jumper385/rover-vcu/CHANGELOG.md

## 0.3.2 (2026-09-02)

### Fix

- replace PN for switcher due to chip blowup

## 0.3.1 (2026-08-02)

### Fix

- removed 3v3 on 1.2v lan core voltage

## 0.3.0 (2026-07-20)

### Feat

- implmeneted revamp with normal ethernet LAN8742A

### Fix

- **eth_phy**: completed revamp with lan8742a

## 0.2.4 (2026-06-16)

### Fix

- added leds to phy

## 0.2.3 (2026-06-15)

### Fix

- tiny fixes; adjusted pin names as check

## 0.2.2 (2026-06-14)

### Fix

- updated 12pin connector footprint + fix drc and exposed vias
- added annotations and 3d models
- final polishes for MFR

## 0.2.1 (2026-06-11)

### Fix

- adde more changes from excel checklist for eth phy
- cleaned up DRC and ERC's for major errors

## 0.2.0 (2026-06-08)

### Feat

- added MVP routing implementation

### Fix

- centering board on layout
- adjusted PNs for PSU systems

## 0.1.0 (2026-06-08)

### Feat

- added can bus channels and psu
- added eth and can with
- completed h63 implementation
- added stm32h563
- added mcu
