jumper385/rover-vcu/Rover VCU.kicad_pcb

## KiCad design Rover VCU.kicad_pcb (2026-08-02)

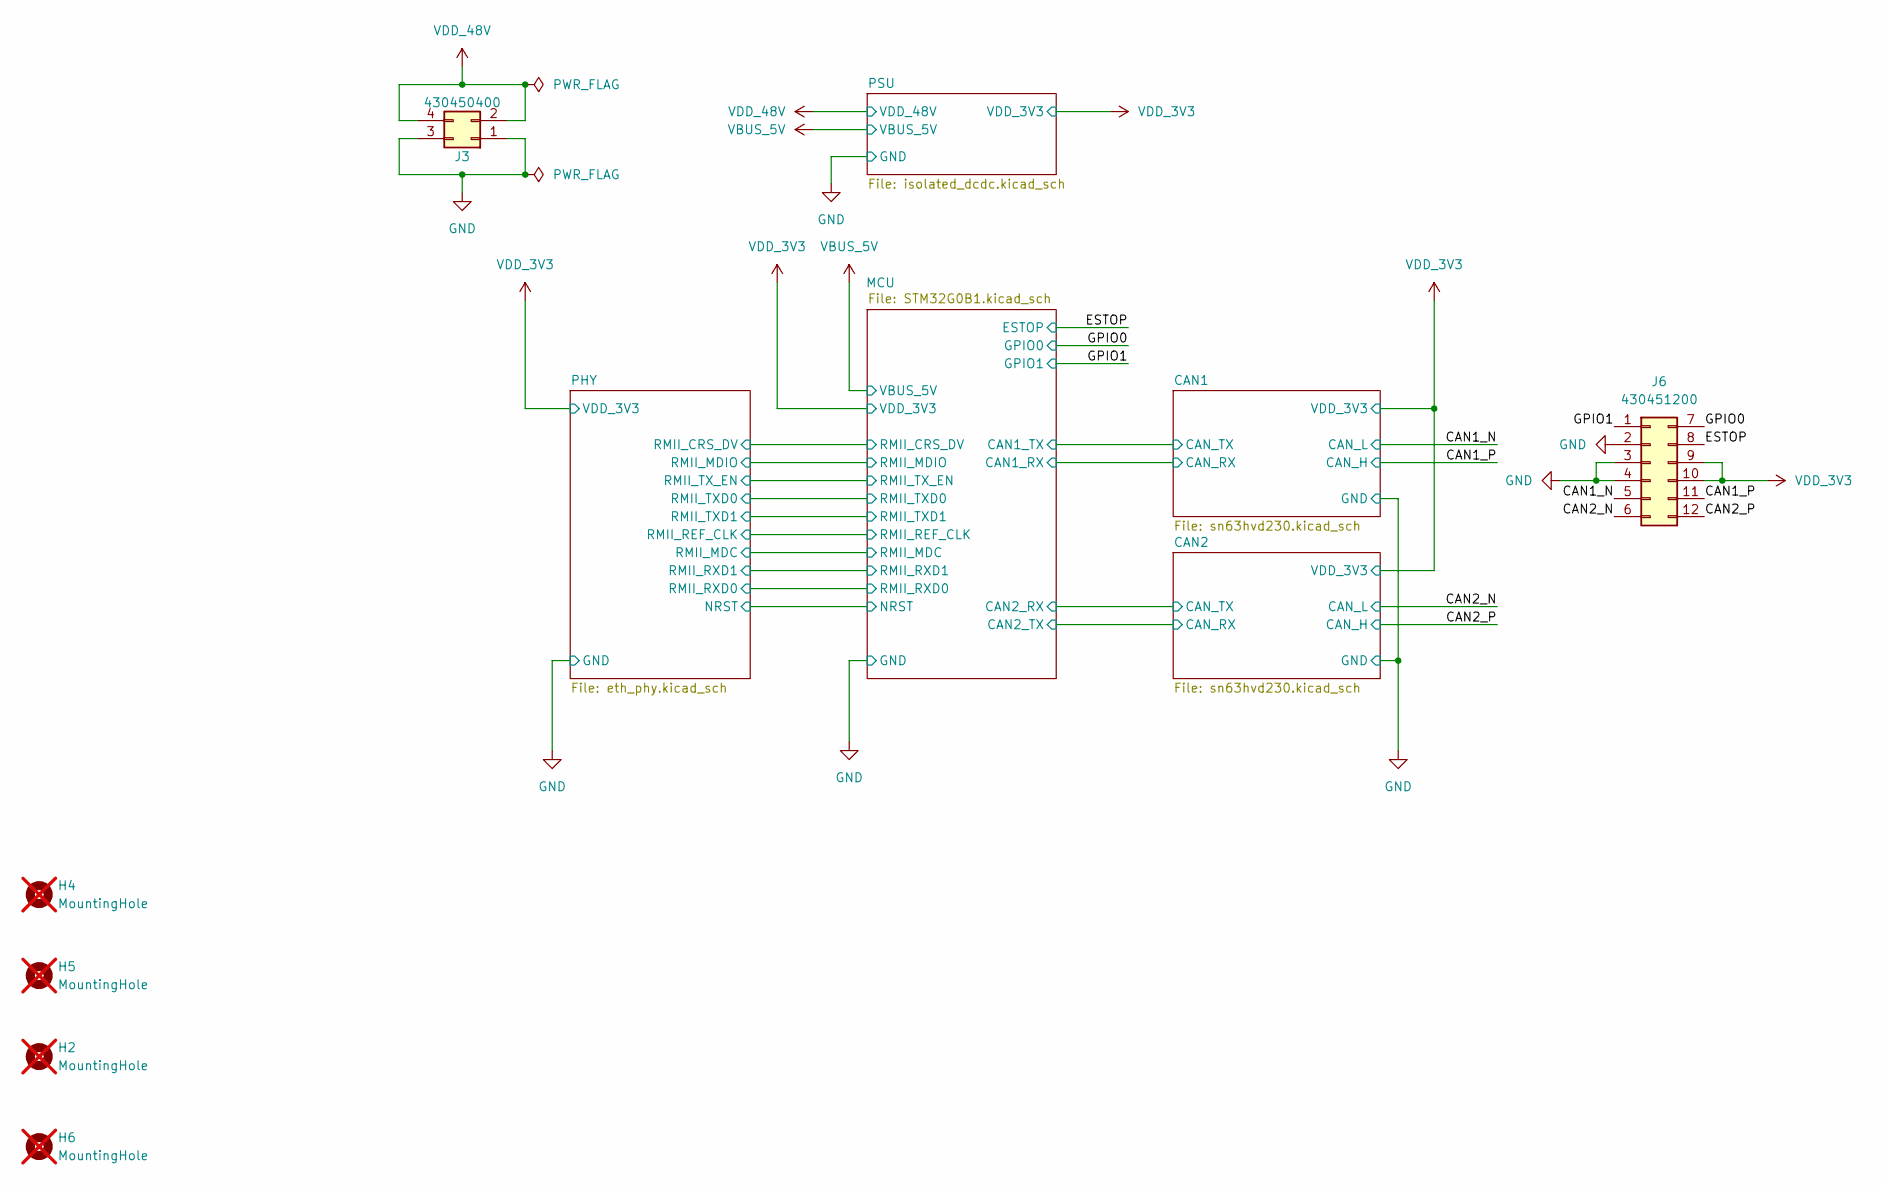
[picture p1: schematic Rover VCU.kicad_sch]

Parts:
H2, H4, H5, H6: MountingHole; MountingHole_3.2mm_M3; not fitted
J3: 430450400; Molex_Micro-Fit_3.0_43045-0400_2x02_P3.00mm_Horizontal; MFR_PN1 430450400; JLC_PN C122413
J6: 430451200; Molex_Micro-Fit_3.0_43045-1200_2x06_P3.00mm_Horizontal; MFR_PN1 430451200; JLC_PN C277636

Connections:
/CAN1_N: J6.5; also elsewhere on the board
/CAN1_P: J6.11; also elsewhere on the board
/CAN2_N: J6.6; also elsewhere on the board
/CAN2_P: J6.12; also elsewhere on the board
/ESTOP: J6.8; also elsewhere on the board
/GPIO0: J6.7; also elsewhere on the board
/GPIO1: J6.1; also elsewhere on the board
/VDD_3V3: J6.9, J6.10; also elsewhere on the board
/VDD_48V: J3.2, J3.4; also elsewhere on the board
GND: J3.1, J3.3, J6.2, J6.3, J6.4; also elsewhere on the board

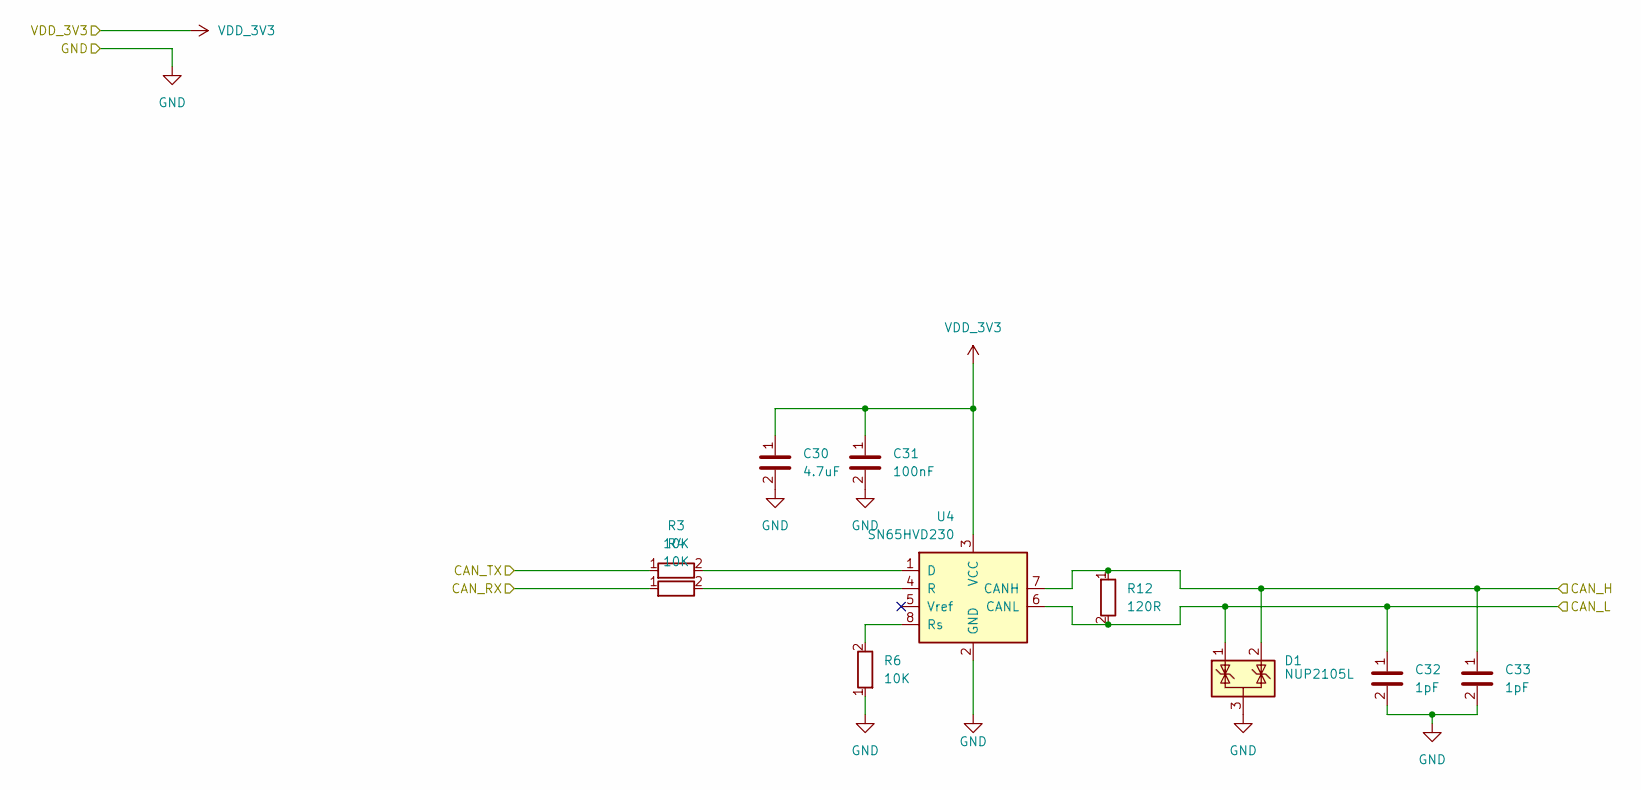
[picture p2: schematic sn63hvd230.kicad_sch]

Parts:
C30: 4.7uF; C_0402; Voltage Rating 10V; MFR_PN1 CL05A475MP5NRNC; JLC_PN C23733
C31: 100nF; C_0402; Voltage Rating 16V; MFR_PN1 CL05B104KO5NNNC; JLC_PN C1525
C32, C33: 1pF; C_0402; Voltage Rating 50V; MFR_PN1 0402CG1R0C500NT; JLC_PN C1550
D1: NUP2105L; SOT-23; MFR_PN1 NUP2105LT1G; JLC_PN C20617923
R3, R4, R6: 10K; R_0402; JLC_PN C25744
R12: 120R; R_0402; MFR_PN1 0402WGF1200TCE; JLC_PN C25079
U4: SN65HVD230; SOIC-8_3.9x4.9mm_P1.27mm; MFR_PN1 SN65HVD230DR; JLC_PN C12084

Connections:
/CAN1_N: C32.1, D1.1 (K), R12.2, U4.6 (CANL); also elsewhere on the board
/CAN1_P: C33.1, D1.2 (K), R12.1, U4.7 (CANH); also elsewhere on the board
/MCU/CAN1_RX: R4.1; also elsewhere on the board
/MCU/CAN1_TX: R3.1; also elsewhere on the board
/VDD_3V3: C30.1, C31.1, U4.3 (VCC); also elsewhere on the board
GND: C30.2, C31.2, C32.2, C33.2, D1.3 (A), R6.1, U4.2 (GND); also elsewhere on the board
unnamed: R3.2, U4.1 (D)
unnamed: R4.2, U4.4 (R)
unnamed: R6.2, U4.8 (Rs)

Parts of its further copies:
C34: 4.7uF; C_0402; Voltage Rating 10V; MFR_PN1 CL05A475MP5NRNC; JLC_PN C23733
C35: 100nF; C_0402; Voltage Rating 16V; MFR_PN1 CL05B104KO5NNNC; JLC_PN C1525
C36, C37: 1pF; C_0402; Voltage Rating 50V; MFR_PN1 0402CG1R0C500NT; JLC_PN C1550
D2: NUP2105L; SOT-23; MFR_PN1 NUP2105LT1G; JLC_PN C20617923
R7, R8, R9: 10K; R_0402; JLC_PN C25744
R13: 120R; R_0402; MFR_PN1 0402WGF1200TCE; JLC_PN C25079
U5: SN65HVD230; SOIC-8_3.9x4.9mm_P1.27mm; MFR_PN1 SN65HVD230DR; JLC_PN C12084

Connections of its further copies:
/CAN2_N: C36.1, D2.1 (K), R13.2, U5.6 (CANL); also elsewhere on the board
/CAN2_P: C37.1, D2.2 (K), R13.1, U5.7 (CANH); also elsewhere on the board
/MCU/CAN2_RX: R7.1; also elsewhere on the board
/MCU/CAN2_TX: R8.1; also elsewhere on the board
/VDD_3V3: C34.1, C35.1, U5.3 (VCC); also elsewhere on the board
GND: C34.2, C35.2, C36.2, C37.2, D2.3 (A), R9.1, U5.2 (GND); also elsewhere on the board
unnamed: R7.2, U5.1 (D)
unnamed: R8.2, U5.4 (R)
unnamed: R9.2, U5.8 (Rs)

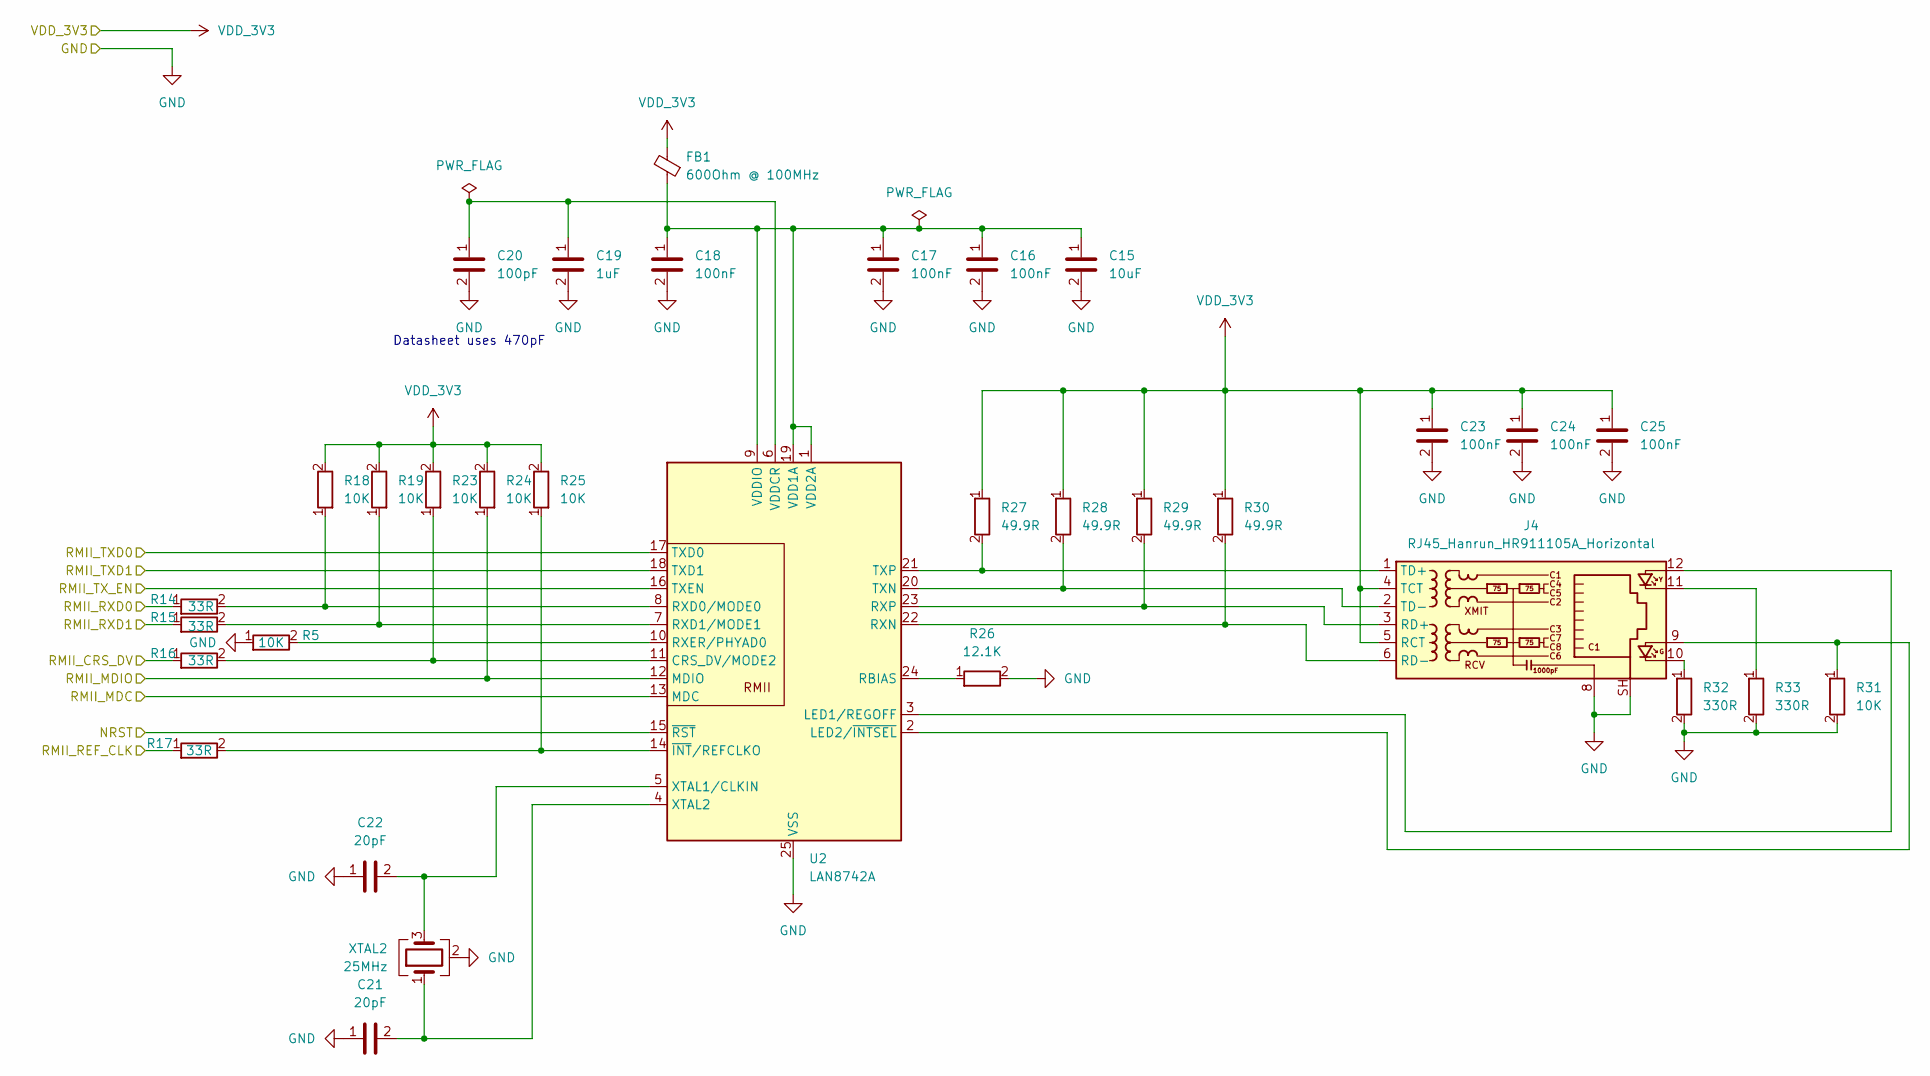
[picture p3: schematic eth_phy.kicad_sch]

Parts:
C15: 10uF; C_0402; Voltage Rating 6.3V; MFR_PN1 CL05A106MQ5NUNC; JLC_PN C15525
C16, C17, C18, C23, C24, C25: 100nF; C_0402; Voltage Rating 16V; MFR_PN1 CL05B104KO5NNNC; JLC_PN C1525
C19: 1uF; C_0402; Voltage Rating 25V; MFR_PN1 CL05A105KA5NQNC; JLC_PN C52923
C20: 100pF; C_0402; Voltage Rating 50V; MFR_PN1 0402CG101J500NT; JLC_PN C1546
C21, C22: 20pF; C_0402; Voltage Rating 50V; MFR_PN1 0402CG200J500NT; JLC_PN C1554
FB1: 600Ohm @ 100MHz; C_0603_1608Metric; MFR_PN1 BLM18KG601SH1D; JLC_PN C1002
J4: RJ45_Hanrun_HR911105A_Horizontal; MFR_PN1 HR911105A; JLC_PN C12074
R5, R18, R19, R23, R24, R25, R31: 10K; R_0402; JLC_PN C25744
R14, R15, R16, R17: 33R; R_0402; JLC_PN C25105
R26: 12.1K; R_0402; MFR_PN1 0805W8F1212T5E; JLC_PN C17431
R27, R28, R29, R30: 49.9R; R_0402; JLC_PN C25120
R32, R33: 330R; R_0402; JLC_PN C25104
U2: LAN8742A; VQFN-24-1EP_4x4mm_P0.5mm_EP2.5x2.5mm_ThermalVias; MFR_PN1 LAN8742AI-CZ-TR; JLC_PN C621425
XTAL2: 25MHz; Crystal_SMD_3225-4Pin_3.2x2.5mm; MFR_PN1 X322525MOB4SI; JLC_PN C9006

Connections:
/MCU/NRST: U2.15 (~RST); also elsewhere on the board
/MCU/RMII_CRS_DV: R16.1; also elsewhere on the board
/MCU/RMII_MDC: U2.13 (MDC); also elsewhere on the board
/MCU/RMII_MDIO: R24.1, U2.12 (MDIO); also elsewhere on the board
/MCU/RMII_REF_CLK: R17.1; also elsewhere on the board
/MCU/RMII_RXD0: R14.1; also elsewhere on the board
/MCU/RMII_RXD1: R15.1; also elsewhere on the board
/MCU/RMII_TXD0: U2.17 (TXD0); also elsewhere on the board
/MCU/RMII_TXD1: U2.18 (TXD1); also elsewhere on the board
/MCU/RMII_TX_EN: U2.16 (TXEN); also elsewhere on the board
/VDD_3V3: C23.1, C24.1, C25.1, FB1.2, J4.4 (TCT), J4.5 (RCT), R18.2, R19.2, R23.2, R24.2, R25.2, R27.1, R28.1, R29.1, R30.1; also elsewhere on the board
GND: C15.2, C16.2, C17.2, C18.2, C19.2, C20.2, C21.1, C22.1, C23.2, C24.2, C25.2, J4.8, J4.SH, R5.1, R26.2, R31.2, R32.2, R33.2, U2.25 (VSS), XTAL2.2 (G), XTAL2.4 (G); also elsewhere on the board
unnamed: J4.10, R32.1
unnamed: J4.11, R33.1
unnamed: J4.3 (RD+), R29.2, U2.23 (RXP)
unnamed: J4.6 (RD-), R30.2, U2.22 (RXN)
unnamed: J4.1 (TD+), R27.2, U2.21 (TXP)
unnamed: J4.2 (TD-), R28.2, U2.20 (TXN)
unnamed: R16.2, R23.1, U2.11 (CRS_DV/MODE2)
unnamed: J4.12, U2.3 (LED1/REGOFF)
unnamed: J4.9, R31.1, U2.2 (LED2/~INTSEL)
unnamed: R26.1, U2.24 (RBIAS)
unnamed: R14.2, R18.1, U2.8 (RXD0/MODE0)
unnamed: R15.2, R19.1, U2.7 (RXD1/MODE1)
unnamed: R5.2, U2.10 (RXER/PHYAD0)
unnamed: C15.1, C16.1, C17.1, C18.1, FB1.1, U2.1 (VDD2A), U2.9 (VDDIO), U2.19 (VDD1A)
unnamed: C19.1, C20.1, U2.6 (VDDCR)
unnamed: C22.2, U2.5 (XTAL1/CLKIN), XTAL2.3
unnamed: C21.2, U2.4 (XTAL2), XTAL2.1
unnamed: R17.2, R25.1, U2.14 (~INT/REFCLKO)

Notes on the sheet:
Datasheet uses 470pF

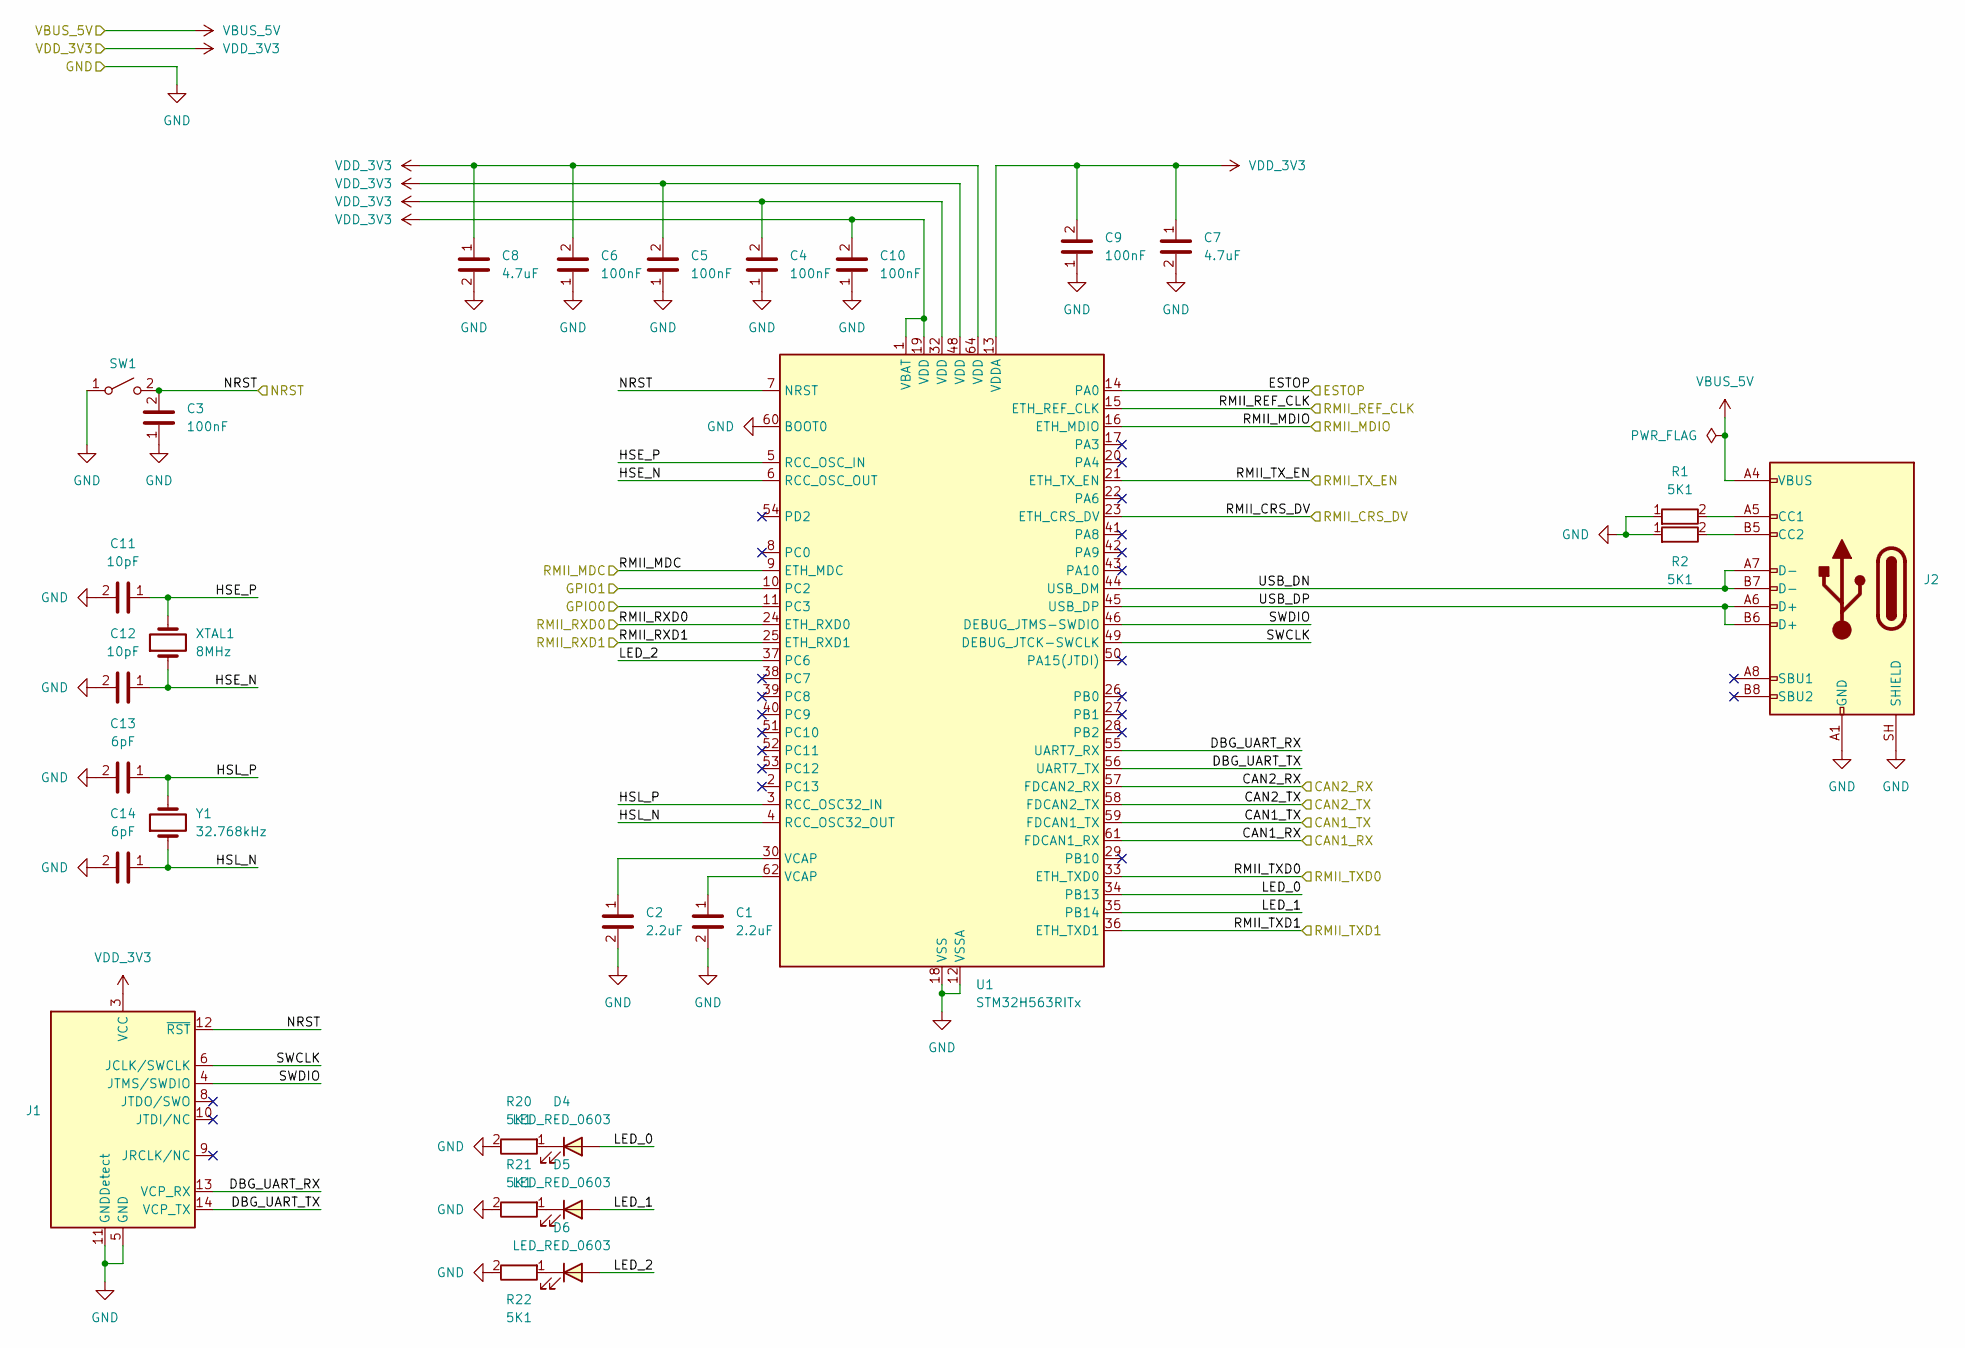
[picture p4: schematic STM32G0B1.kicad_sch]

Parts:
C1, C2: 2.2uF; C_0402; Voltage Rating 6.3V; MFR_PN1 CL05A225MQ5NSNC; JLC_PN C12530
C3, C4, C5, C6, C9, C10: 100nF; C_0402; Voltage Rating 16V; MFR_PN1 CL05B104KO5NNNC; JLC_PN C1525
C7, C8: 4.7uF; C_0402; Voltage Rating 10V; MFR_PN1 CL05A475MP5NRNC; JLC_PN C23733
C11, C12: 10pF; C_0402; Voltage Rating 50V; MFR_PN1 CL05C100JB5NNNC; JLC_PN C32949
C13, C14: 6pF; C_0402; Voltage Rating 50V; MFR_PN1 0402CG6R0C500NT; JLC_PN C30274
D4, D5, D6: LED_RED_0603; LED_0603_1608Metric; MFR_PN1 IN-S63FTHIR; JLC_PN C2286
J1: Conn_ST_STDC14; PinHeader_2x07_P1.27mm_Vertical_SMD; MFR_PN1 3220-14-0100-00; JLC_PN C27985148
J2: USB4105-GF-A; USB_C_Receptacle_GCT_USB4105-xx-A_16P_TopMnt_Horizontal; MFR_PN1 USB4105-GF-A; JLC_PN C393939
R1, R2, R20, R21, R22: 5K1; R_0402; JLC_PN C25905
SW1: TS-1088-AR02016; SW_SPST_TS-1088-xR020; MFR_PN1 C720477
U1: STM32H563RITx; LQFP-64_10x10mm_P0.5mm; JLC_PN C20619634
XTAL1: 8MHz; Crystal_SMD_5032-2Pin_5.0x3.2mm; MFR_PN1 X50328MSB2GI; JLC_PN C115962
Y1: 32.768kHz; Crystal_SMD_3215-2Pin_3.2x1.5mm; MFR_PN1 Q13FC13500004; JLC_PN C32346

Connections:
/ESTOP: U1.14 (PA0); also elsewhere on the board
/GPIO0: U1.11 (PC3); also elsewhere on the board
/GPIO1: U1.10 (PC2); also elsewhere on the board
/MCU/CAN1_RX: U1.61 (FDCAN1_RX); also elsewhere on the board
/MCU/CAN1_TX: U1.59 (FDCAN1_TX); also elsewhere on the board
/MCU/CAN2_RX: U1.57 (FDCAN2_RX); also elsewhere on the board
/MCU/CAN2_TX: U1.58 (FDCAN2_TX); also elsewhere on the board
/MCU/DBG_UART_RX: J1.13 (VCP_RX), U1.55 (UART7_RX)
/MCU/DBG_UART_TX: J1.14 (VCP_TX), U1.56 (UART7_TX)
/MCU/HSE_N: C12.1, U1.6 (RCC_OSC_OUT), XTAL1.1
/MCU/HSE_P: C11.1, U1.5 (RCC_OSC_IN), XTAL1.2
/MCU/HSL_N: C14.1, U1.4 (RCC_OSC32_OUT), Y1.1
/MCU/HSL_P: C13.1, U1.3 (RCC_OSC32_IN), Y1.2
/MCU/LED_0: D4.2 (A), U1.34 (PB13)
/MCU/LED_1: D5.2 (A), U1.35 (PB14)
/MCU/LED_2: D6.2 (A), U1.37 (PC6)
/MCU/NRST: C3.2, J1.12 (~RST), SW1.2 (B), U1.7 (NRST); also elsewhere on the board
/MCU/RMII_CRS_DV: U1.23 (ETH_CRS_DV); also elsewhere on the board
/MCU/RMII_MDC: U1.9 (ETH_MDC); also elsewhere on the board
/MCU/RMII_MDIO: U1.16 (ETH_MDIO); also elsewhere on the board
/MCU/RMII_REF_CLK: U1.15 (ETH_REF_CLK); also elsewhere on the board
/MCU/RMII_RXD0: U1.24 (ETH_RXD0); also elsewhere on the board
/MCU/RMII_RXD1: U1.25 (ETH_RXD1); also elsewhere on the board
/MCU/RMII_TXD0: U1.33 (ETH_TXD0); also elsewhere on the board
/MCU/RMII_TXD1: U1.36 (ETH_TXD1); also elsewhere on the board
/MCU/RMII_TX_EN: U1.21 (ETH_TX_EN); also elsewhere on the board
/MCU/SWCLK: J1.6 (JCLK/SWCLK), U1.49 (DEBUG_JTCK-SWCLK)
/MCU/SWDIO: J1.4 (JTMS/SWDIO), U1.46 (DEBUG_JTMS-SWDIO)
/MCU/USB_DN: J2.A7 (D-), J2.B7 (D-), U1.44 (USB_DM)
/MCU/USB_DP: J2.A6 (D+), J2.B6 (D+), U1.45 (USB_DP)
/VBUS_5V: J2.A4 (VBUS), J2.A9 (VBUS), J2.B4 (VBUS), J2.B9 (VBUS); also elsewhere on the board
/VDD_3V3: C4.2, C5.2, C6.2, C7.1, C8.1, C9.2, C10.2, J1.3 (VCC), U1.1 (VBAT), U1.13 (VDDA), U1.19 (VDD), U1.32 (VDD), U1.48 (VDD), U1.64 (VDD); also elsewhere on the board
GND: C1.2, C2.2, C3.1, C4.1, C5.1, C6.1, C7.2, C8.2, C9.1, C10.1, C11.2, C12.2, C13.2, C14.2, J1.5 (GND), J1.7 (GND), J1.11 (GNDDetect), J2.A1 (GND), J2.A12 (GND), J2.B1 (GND), J2.B12 (GND), J2.SH (SHIELD), R1.1, R2.1, R20.2, R21.2, R22.2, SW1.1 (A), U1.12 (VSSA), U1.18 (VSS), U1.31 (VSS), U1.47 (VSS), U1.60 (BOOT0), U1.63 (VSS); also elsewhere on the board
unnamed: C1.1, U1.62 (VCAP)
unnamed: C2.1, U1.30 (VCAP)
unnamed: D4.1 (K), R20.1
unnamed: D5.1 (K), R21.1
unnamed: D6.1 (K), R22.1
unnamed: J2.A5 (CC1), R1.2
unnamed: J2.B5 (CC2), R2.2

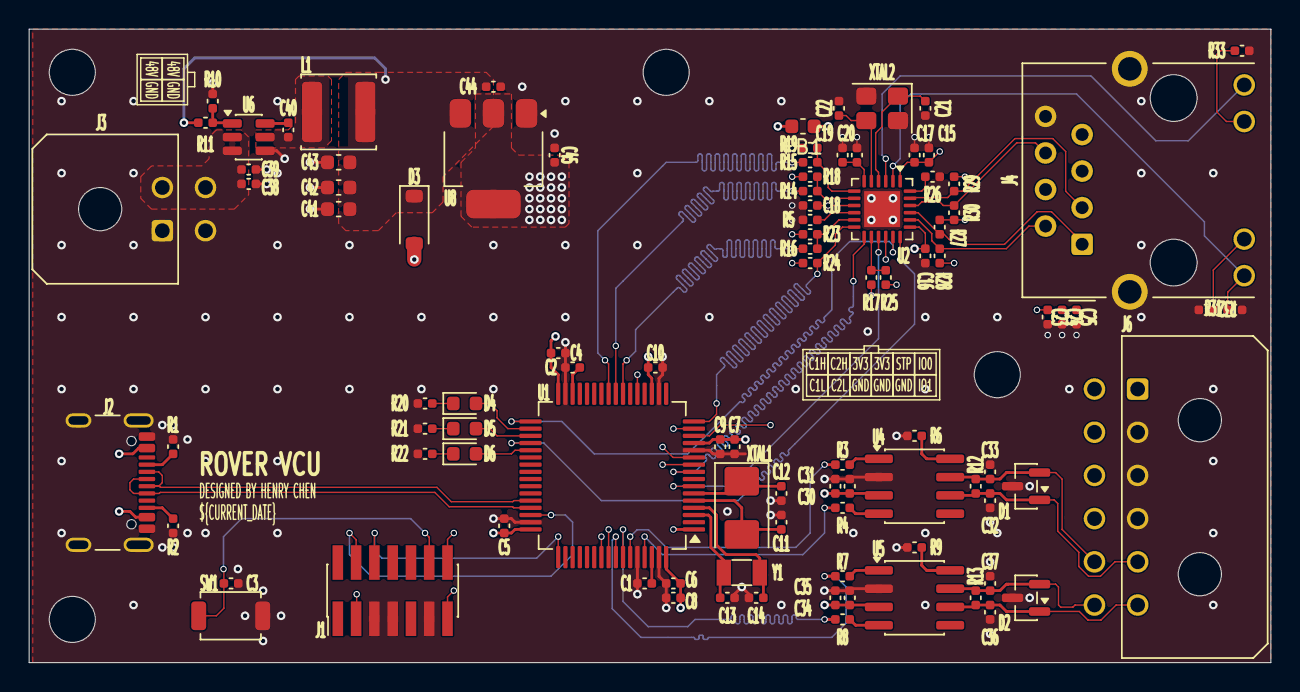
[picture p5: board Rover VCU.kicad_pcb from above]

Board: 4 copper layers, 86.2 x 44.0 mm, 101 parts (0 on the bottom side), 73 nets.

Other parts of the board:
C38, C40: 100nF; C_0402
C39, C44, C45: 1uF; C_0402
C41, C42, C43: 22uF; C_0603_1608Metric
D3: B5819W; D_SOD-123
L1: 15uH; L_Sunlord_SWPA5040S
R10: 10K; R_0402
R11: 56K; R_0402
U6: LMR51610; SOT-23-6
U8: NCP1117-3.3_SOT223; SOT-223-3_TabPin2

Their connections:
/VBUS_5V: D3.2 (A); also elsewhere on the board
/VDD_3V3: C45.1, U8.2 (VO); also elsewhere on the board
/VDD_48V: C38.1, C39.1, U6.2 (EN), U6.3 (VIN); also elsewhere on the board
GND: C38.2, C39.2, C41.2, C42.2, C43.2, C44.2, C45.2, R10.2, U6.4 (GND), U8.1 (GND); also elsewhere on the board
unnamed: C41.1, C42.1, C43.1, C44.1, D3.1 (K), L1.2, R11.1, U8.3 (VI)
unnamed: C40.2, U6.6 (CB)
unnamed: R10.1, R11.2, U6.1 (FB)
unnamed: C40.1, L1.1, U6.5 (SW)
