jumper385/rover-vcu/(commit log)

2026-06-03 added kicad lib submodule
2026-06-03 feat: added mcu
    [Rover VCU.kicad_sch]
2026-06-04 feat: added stm32h563
2026-06-07 feat: completed h63 implementation
    [Rover VCU.kicad_sch]
2026-06-08 feat: added eth and can with
    [Rover VCU.kicad_sch, STM32G0B1.kicad_sch, eth_phy.kicad_sch, sn63hvd230.kicad_sch]
2026-06-08 feat: added can bus channels and psu
    [Rover VCU.kicad_sch, eth_phy.kicad_sch, isolated_dcdc.kicad_sch]
2026-06-08 ci: added pcb file for build complete
    [Rover VCU.kicad_pcb]
2026-06-08 ci: kicad 10
2026-06-08 ci: fixing CI to generate outputs
    [Rover VCU.kicad_pcb]
2026-06-08 bump: version 0.0.1 → 0.1.0
2026-06-08 fix: adjusted PNs for PSU systems
    [isolated_dcdc.kicad_sch]
2026-06-08 feat: added MVP routing implementation
    [Rover VCU.kicad_pcb, Rover VCU.kicad_sch, STM32G0B1.kicad_sch, eth_phy.kicad_sch, isolated_dcdc.kicad_sch, sn63hvd230.kicad_sch]
2026-06-08 fix: centering board on layout
    [Rover VCU.kicad_pcb]
2026-06-08 bump: version 0.1.0 → 0.2.0
2026-06-08 chore: updating Rover
    [Rover VCU.kicad_pcb]
2026-06-08 fix: cleaned up DRC and ERC's for major errors
    [Rover VCU.kicad_pcb, Rover VCU.kicad_sch, eth_phy.kicad_sch, isolated_dcdc.kicad_sch]
2026-06-11 fix: adde more changes from excel checklist for eth phy
    [Rover VCU.kicad_pcb, eth_phy.kicad_sch]
2026-06-11 bump: version 0.2.0 → 0.2.1
2026-06-12 fix: final polishes for MFR
    [Rover VCU.kicad_pcb, Rover VCU.kicad_sch, STM32G0B1.kicad_sch, eth_phy.kicad_sch, isolated_dcdc.kicad_sch, sn63hvd230.kicad_sch]
2026-06-12 fix: added annotations and 3d models
    [Rover VCU.kicad_pcb, Rover VCU.kicad_sch]
2026-06-14 fix: updated 12pin connector footprint + fix drc and exposed vias
    [Rover VCU.kicad_pcb, Rover VCU.kicad_sch, STM32G0B1.kicad_sch, isolated_dcdc.kicad_sch]
2026-06-14 bump: version 0.2.1 → 0.2.2
2026-06-15 fix: tiny fixes; adjusted pin names as check
    [Rover VCU.kicad_pcb, STM32G0B1.kicad_sch]
2026-06-15 bump: version 0.2.2 → 0.2.3
2026-06-16 fix: added leds to phy
    [Rover VCU.kicad_pcb, eth_phy.kicad_sch]
2026-06-16 bump: version 0.2.3 → 0.2.4
2026-07-13 chore: pushes; changes untracked
    [sn63hvd230.kicad_sch]
2026-07-13 feat: implmeneted revamp with normal ethernet LAN8742A
    [Rover VCU.kicad_pcb, Rover VCU.kicad_sch, eth_phy.kicad_sch]
2026-07-20 fix(eth_phy): completed revamp with lan8742a
    BREAKING CHANGE:
    [Rover VCU.kicad_pcb, Rover VCU.kicad_sch, STM32G0B1.kicad_sch, eth_phy.kicad_sch, isolated_dcdc.kicad_sch, sn63hvd230.kicad_sch]
2026-07-20 bump: version 0.2.4 → 0.3.0
2026-08-02 fix: removed 3v3 on 1.2v lan core voltage
    [Rover VCU.kicad_pcb, eth_phy.kicad_sch]
2026-08-02 bump: version 0.3.0 → 0.3.1
2026-09-02 fix: replace PN for switcher due to chip blowup
    [isolated_dcdc.kicad_sch]
2026-09-02 bump: version 0.3.1 → 0.3.2
